vhkarendus/VHK_Telemeetria/andurid/1.rpm/README.md

**Üldinfo:**
Elektroonikaks läheb vaja unipolar hall effect sensorit, opampi, (schmitt triggerit)

**Märkused:**
* Hall effect andur peab kindlasti olema unipolar
* Schmitt triggerit läheb ainult siis vaja, kui interruptidega süsteem ei tööta. Kuna interruptid on nii või naa RISING modeis, siis Schmitt triggeri töö teeb see ise ära.

**Komponendid:**

| **Nimi** | **Link** | **Hind** | **Tüüp** |
|---|---|---|---|
| INFINEON TLE4906LHALA1 | https://www.lemona.ee/hall-effect-switch-bipolar-sso.html | 1.89 | Hall effect sensor |
| Microchip - MCP6041-I/P | [https://www.lemona.ee/ic-op-amp.html](https://www.lemona.ee/ic-op-amp-cmos-6041-dip8.html) | 1.24 | Operational Amplifier |

Sheet_1_2024-05-12
