vhkarendus/VHK_Telemeetria/tutorialid/images/04-vooluandur/04-multimeeter.jpg

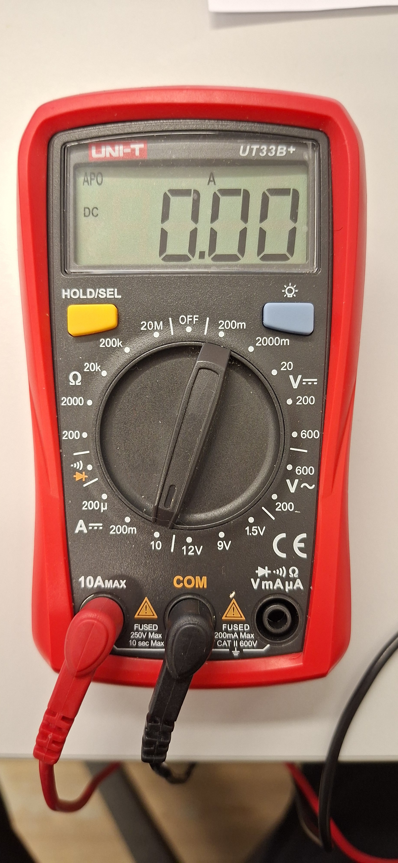
tutorialid/images/04-vooluandur/04-multimeeter.jpg
