vhkarendus/VHK_Telemeetria/andurid/5.gps/gps_measure/README.md

## Sensor
| **Andur** | **Pood** | **Link** |
|---|---|---|
| U-BLOX NEO-7M | Lemona | https://www.lemona.ee/gps-module-u-blox-neo-7m-for-arduinor-wpi430.html |
| U-BLOX NEO-7M | Oomipood | https://www.oomipood.ee/product/product?product_id=1150845 |
