vhkarendus/VHK_Telemeetria/andurid/1.rpm/Elektriskeem-VHK-Telemeetria-RPM-sensor_2.0_2024-05-12.pdf

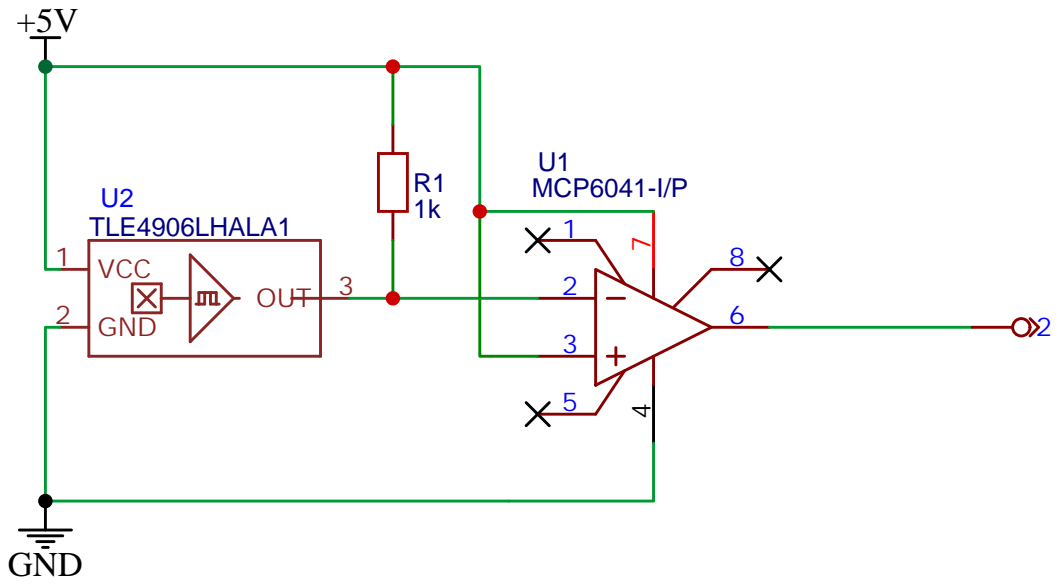
[picture p23: page 1]
