vhkarendus/VHK_Telemeetria/(commit log)

2024-02-23 Algne versioon telemeetria UIst, streamlit+bokeh
    vt readme
    [2024-02-21.csv, 2024-02-22.csv]
2024-03-10 Rename dev_temp. to dev_temp.ino
    parandasin failinime ära
    [dev_temp.ino]
2024-03-10 Lisasin esialgse koodi, aga see on hetkel ebatäpne ning ei mööda täpselt pöördeid minutis. Lisasin README, kuhu panin kirja võimalikud hall effect sensorid ja muud infot.
2024-03-11 muutsin tööpõhimõtet - kasutades interrupte möödetakse nüüd iga täispöörde intervall, ning seeläbi leitakse RPM. Peaks olema täpne mõõtmine. Muutsin selle arvelt ka vajaminevaid elektroonika komponen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
2024-03-20 added sensor list to readme
2024-05-07 Tegin parandused RPM mõõtmise koodile Nimetasin ka kausta ümber, et see töötaks Arduino IDE-ga korrektselt. Nüüd peaks kood olema täielikult töökorras
2024-05-14 new data format
    [output.csv]
2025-03-21 v2
    uusim ja kõige parem versioon rakendusest. toimib korrektselt ka nüüd muudetud andmeformaadiga. Praeguse seisuga ei ole veel arvutatud väärtuseid (võimsus, kiirus, jne) lisanud, lisan need siis kui vaja
    [2024-02-01.csv]
